tweej/IrrigationControl/IrrigationControl.brd

## EAGLE design IrrigationControl.brd (2015-01-13)

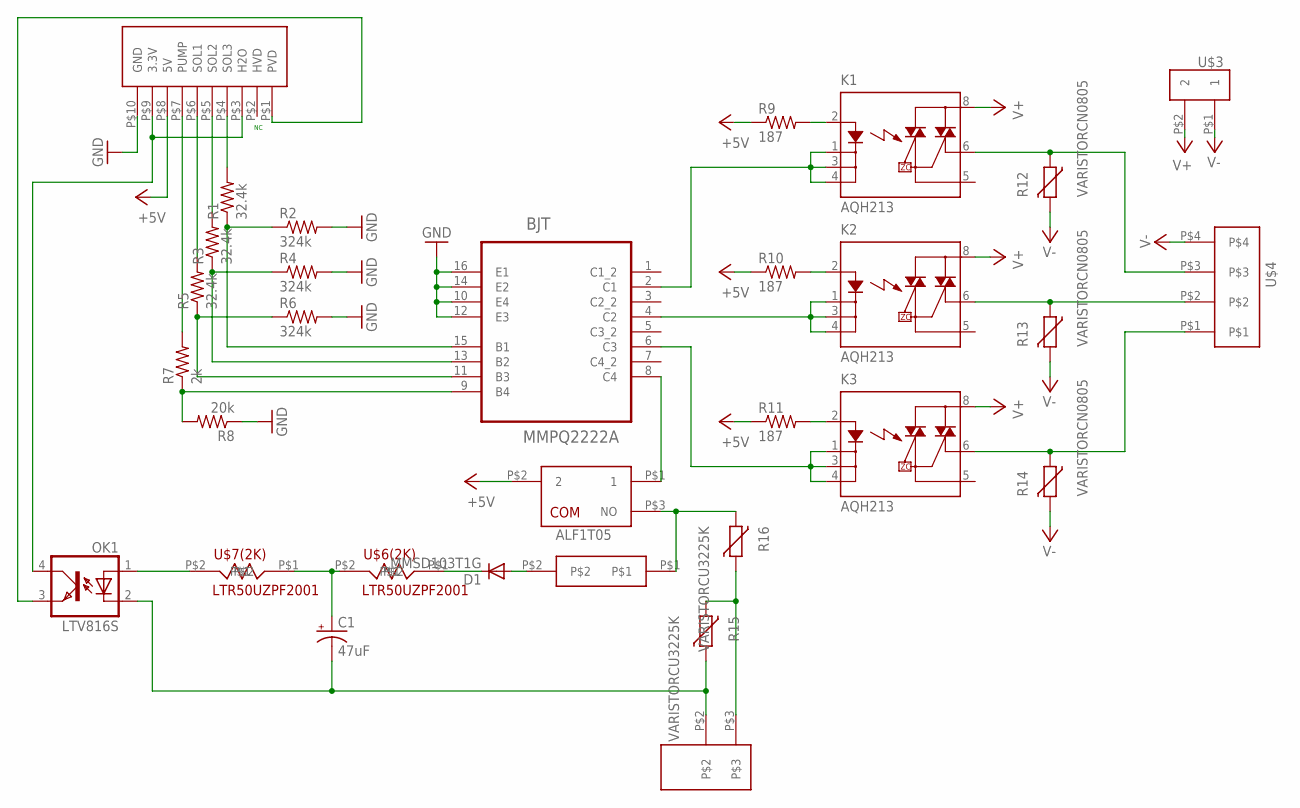
[picture p1: schematic IrrigationControl.sch]

Parts:
ALF1T05: ALF1T05; TMP
BJT: MMPQ2222A; SOIC127P600X175-16N
C1: 47uF; E5-10,5
D1: MMSD103T1G; SOD123
K1, K2, K3: AQH213; DIL07
OK1: LTV816S; SMD4
R1, R3, R5: 32.4k; R0805
R2, R4, R6: 324k; R0805
R7: 2k; R0805
R8: 20k; R0805
R9, R10, R11: 187; R0805
R12, R13, R14: VARISTORCN0805; CT/CN0805
R15, R16: VARISTORCU3225K; CU3225K
U$1: OSTT7030150
U$2: OSTTE100104
U$3: OSTTC020162
U$4: OSTTE040104; OSTTEX040104
U$5: SST-357; SST
U$6(2K), U$7(2K): LTR50UZPF2001; WIDE2010

Connections:
+5V: ALF1T05.P$2 (2), R9.1, R10.1, R11.1, U$2.P$8 (5V)
GND: BJT.10 (E4), BJT.12 (E3), BJT.14 (E2), BJT.16 (E1), R2.2, R4.2, R6.2, R8.1, U$2.P$10 (GND)
unnamed: BJT.13 (B2), R3.1, R4.1
unnamed: R7.2, U$2.P$7 (PUMP)
unnamed: BJT.15 (B1), R1.1, R2.1
unnamed: R5.2, U$2.P$6 (SOL1)
unnamed: R3.2, U$2.P$5 (SOL2)
unnamed: BJT.11 (B3), R5.1, R6.1
unnamed: BJT.9 (B4), R7.1, R8.2
unnamed: OK1.4 (COL), U$2.P$3 (H2O), U$2.P$9 (3.3V)
unnamed: ALF1T05.P$1 (1), BJT.8 (C4)
unnamed: ALF1T05.P$3 (NO), R16.2, U$5.P$1
unnamed: K3.2 (A), R11.2
unnamed: K2.2 (A), R10.2
unnamed: K1.2 (A), R9.2
unnamed: BJT.6 (C3), K3.1 (K), K3.3 (K1), K3.4 (K2)
unnamed: BJT.4 (C2), K2.1 (K), K2.3 (K1), K2.4 (K2)
unnamed: BJT.2 (C1), K1.1 (K), K1.3 (K1), K1.4 (K2)
unnamed: K1.6 (DS3), R12.1, U$4.P$3
unnamed: K2.6 (DS3), R13.1, U$4.P$2
unnamed: K3.6 (DS3), R14.1, U$4.P$1
unnamed: D1.A, U$5.P$2
unnamed: R15.2, R16.1, U$1.P$3
unnamed: C1.-, OK1.2 (C), R15.1, U$1.P$2
unnamed: D1.C, U$6(2K).P$1
unnamed: C1.+, U$6(2K).P$2, U$7(2K).P$1
unnamed: OK1.1 (A), U$7(2K).P$2
unnamed: OK1.3 (EMIT), U$2.P$1 (PVD)
unnamed: R1.2, U$2.P$4 (SOL3)
V+: K1.8 (DS1), K2.8 (DS1), K3.8 (DS1), U$3.P$2 (2)
V-: R12.2, R13.2, R14.2, U$3.P$1 (1), U$4.P$4

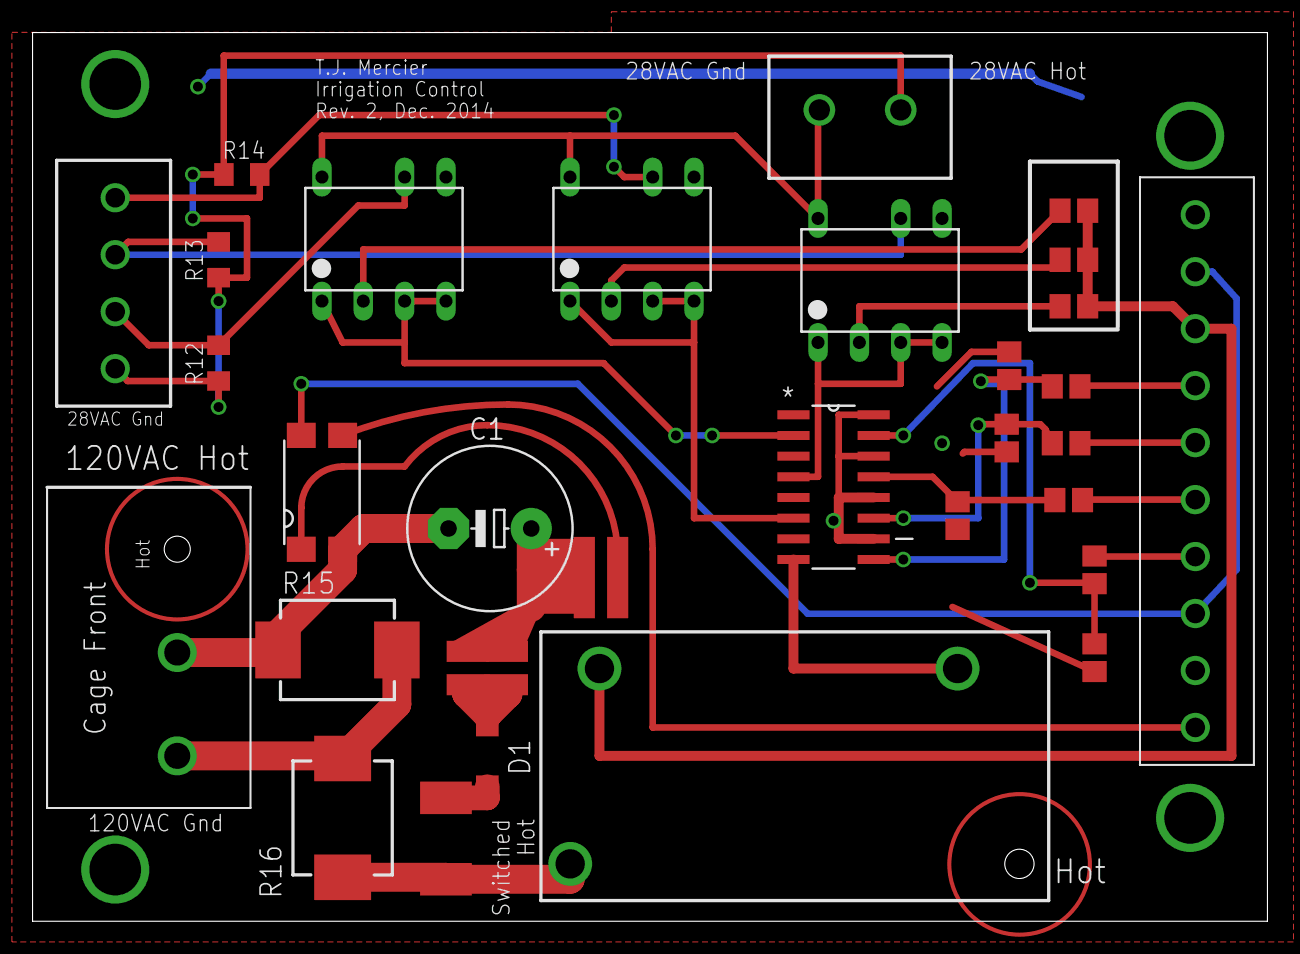
[picture p2: board IrrigationControl.brd from above]

Board: 2 copper layers, 75.9 x 54.6 mm, 31 parts (0 on the bottom side), 31 nets.
