tweej/IrrigationControl/(threads)

Thread 1 (2015-01-14):

Incorrect pad spacing for LTV-816S

tweej, 2015-01-14:
Eagle's included Optocoupler library was used for part LTV-816S. The Eagle library is incorrect for the LTV-816S (and other) package(s). Presumably, the incorrect dimension from the "Outline Dimensions" portion of the Liteon photocoupler datasheet was used during the creation of the library part.

This problem can be worked around by carefully bending and flattening the leads on one side of the LTV-816S 180 degrees, so that they rest underneath the IC. The part is able to be soldered to the PCB if this is done.

On 2014/12/18 the following email was sent to Eagle at support@cadsoftusa.com. As of the writing of this issue (2015/01/14) no response has been received.

"I designed a PCB using the optocoupler library included with Eagle. The LTV-816S device has at least one incorrect package associated with it. I checked the library package and the dimensions are incorrect. The placement of the SMD4 pads are such that they are located at the boundaries of the chip and not its leads. The leads span 10.16mm not 7mm as is used in the library. The actual part now does not fit on my PCB.

http://optoelectronics.liteon.com/upload/download/DS-70-97-0013/S_110_LTV-816%20826%20846%20%28M,%20S,%20S-TA,%20S-TA1,%20S-TP%29%20Series.pdf"

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

Thread 2 (2015-01-18):

Images for Wiki

tweej, 2015-01-18:
http://solutionoptimist.com/2013/12/28/awesome-github-tricks/

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

tweej, 2015-01-23:
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

tweej, 2015-01-23:
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
![uninstalled_300](https://cloud.githubusercontent.com/assets/8267265/5868290/4c549198-a275-11e4-9170-3dfd9652e57a.jpg
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
)

tweej, 2015-01-24:
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

tweej, 2015-01-24:
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

Closed 2015-01-18.
